Victor-lyhan/Rehabilitation-Device/README.md

# Rehabilitation-Device

## Dev
* Software
    1. Control: Arduino, C++, C
    2. Phone App
* Hardware:
    1. Micro-controller: Arduino Mega 2560, ESP32
    2. Electric Modules: WIFI module, Flex Sensor, Pressure Sensor
    3. Solidworks, Fusion360, Matlab

## Science Fair Project
* [Badger State Science And Engineering Fair](https://bssef.org/bssef-2024/)
    1. Category Award - Engineering Cateogiry 1st Place
    2. Grand Award - ISEF Finalist
* Wisconsin/Upper Michigan [JSHS](https://www.uwlax.edu/gel/ypc/jshs/awards/#tm-261402)
    1. Oral Presenter 2nd Place
    2. National JSHS Oral Presenter Finalist

## Abstract
Parkinson's patients often encounter challenges like irregular finger tremors and stiffness. Recent research has underscored the potential benefits of rehabilitation training, crucial for restoring active mobility through passive finger movement and enhancing flexibility.\n\nThis auxiliary rehabilitation device innovatively aided patients with three key features: bending training, diagnostic tremor rating, and life assistance. The design underwent thorough theoretical research on Extensible Pneumatic Muscles (EPM), focusing on bending structure design. The relays and air pumps in the device, controlled by a microcontroller, effectively managed the inflation and deflation of the EPM structure on each finger. This capability actively guided finger during bending training, achieving a maximum flexion angle of 70 degrees with the deviation less than 10%. Additionally, the device evaluated recovery status by analyzing changes in the maximum flexion angle during the patient's self-training finger movements over time. Equipped with an accelerometer, it aided in rating the patients’ finger tremors, enabling at-home monitoring. Moreover, the device extended its functionality to life assistance, often utilized to prevent inadvertent actions by restraining trembling fingers from unintentionally clicking the mouse during movement.\n\nFeatures were proven to be efficient through several experiments conducted. Meanwhile, user safety was ensured by examining the correlation between the EPM bending angle and speed, and the force applied to the patient's fingers. Incorporating a mobile app allowed users to connect to the equipment using Bluetooth protocol, leveraging portability and mobility to enhance the overall convenience and efficiency of the rehabilitation process for patients.

## Slides Intro
[An Auxiliary Rehabilitation Device for Parkinson's Patients with Finger Muscle Tremors and Stiffness](ISEF_Presentation_Final.pptx)
