Victor-lyhan/Rehabilitation-Device/(commit log)

2024-07-26 Basis - Arduino
2024-07-26 esp32 data logging
